EmberHeavyIndustries/AMI-RGB2VGAPLUS/Docs/RGB2VGA2_1s.JPG

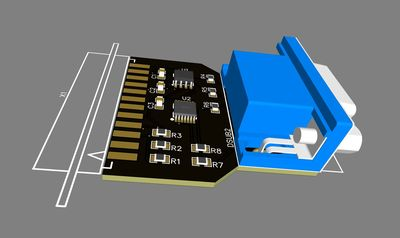
Docs/RGB2VGA2_1s.JPG
