EmberHeavyIndustries/AMI-RGB2VGAPLUS/Hardware/BOM_PCB_RGB2VGA_V2_2023-01-01.csv

ID | Name | Designator | Footprint | Quantity | Manufacturer Part | Manufacturer | Supplier | Supplier Part | Price
1 | 10uF | C2 | C0805 | 1 | CL21A106KPFNNNE | SAMSUNG(三星) | LCSC | C17024 | 0.002
2 | VGA-002 | DSUB2 | D-SUB-TH_VGA-002 | 1 | VGA-002 | BOOMELE(博穆精密) | LCSC | C138387 | 0.036
3 | THS7316D | U1 | SOIC-8_L5.0-W4.0-P1.27-LS6.1-BL | 1 | THS7316D | TI(德州仪器) | LCSC | C544874 | 0.075
4 | SN74HCT14PWR | U2 | TSSOP-14_L5.0-W4.4-P0.65-LS6.4-BL | 1 | SN74HCT14PWR | TI(德州仪器) | LCSC | C133639 | 0.039
5 | DB23_VTX | X1 | DB23_VTX | 1
6 | 100nF | C1,C3 | C0805 | 2 | CC0805KRX7R9BB104 | YAGEO(国巨) | LCSC | C49678 | 0.001
7 | - | R1,R2,R3,R4,R5,R6 | R0805 | 6 | 0805W8F750JT5E (SMT业务专用) | null | LCSC | C20638
8 | 100Ω | R7,R8 | R0805 | 2 | 0805W8F1000T5E | UNI-ROYAL(厚声) | LCSC | C17408
