EmberHeavyIndustries/AMI-RGB2VGAPLUS/Hardware/3D/C138387/VGA-002-solid.stl

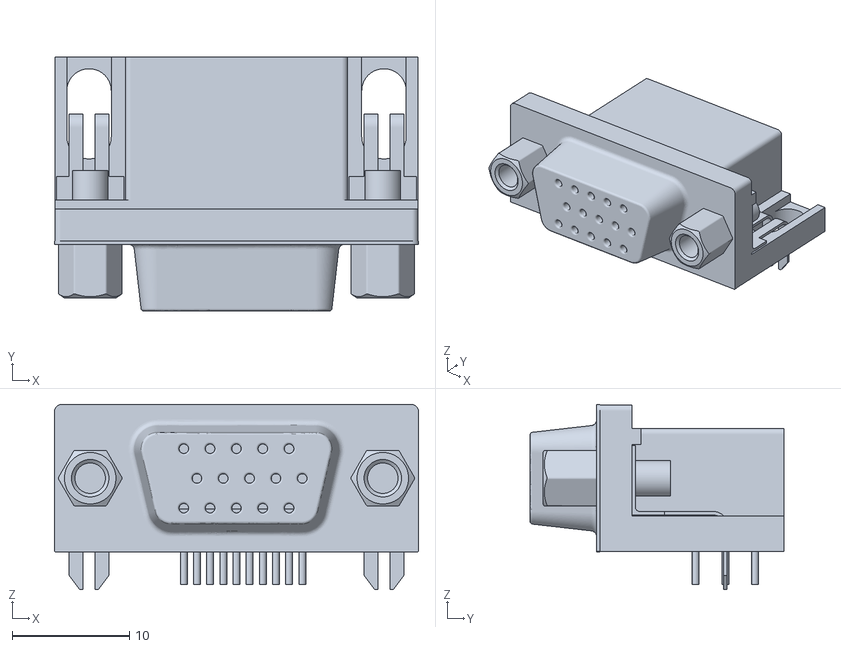
[picture p3: CAD file, 2026-11-02]
Hardware/3D/C138387/VGA-002-solid.stl
31.1 x 21.7 x 15.8
