EmberHeavyIndustries/AMI-RGB2VGAPLUS/Hardware/3D/DB23/DB23-female.step

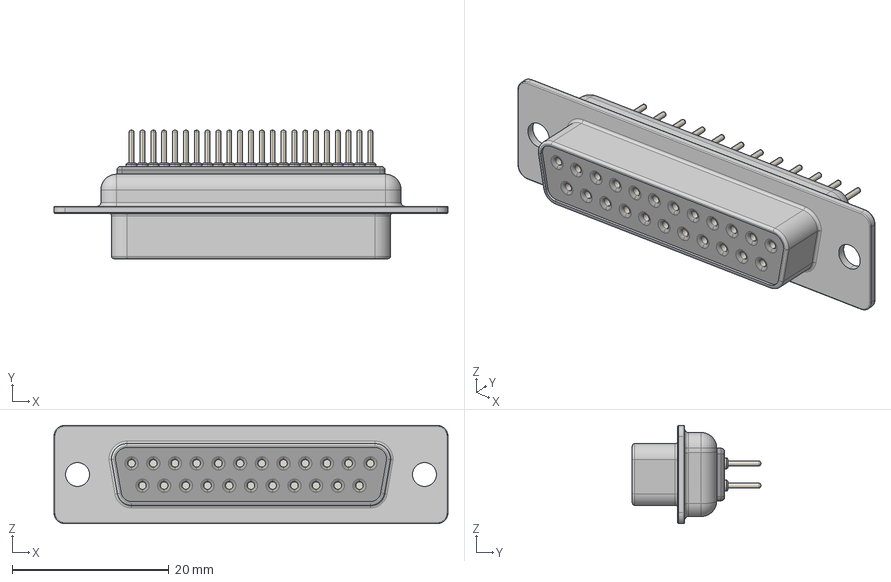
[picture p4: CAD file, 2026-11-02]
Hardware/3D/DB23/DB23-female.step
50.3 x 16.4 x 12.6 mm
