EmberHeavyIndustries/AMI-RGB2VGAPLUS/stl/lid.stl

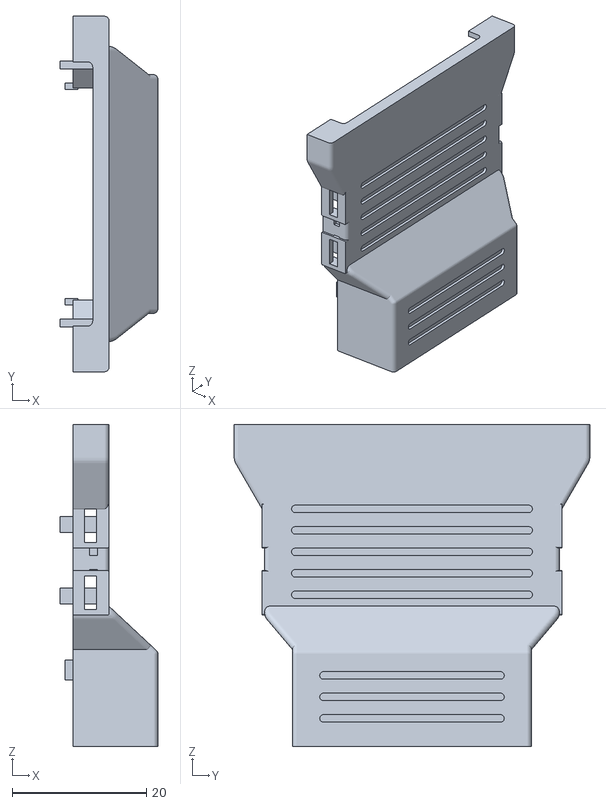
[picture p5: CAD file, 2026-11-02]
stl/lid.stl
14.6 x 53.0 x 48.0
