EmberHeavyIndustries/AMI-RGB2VGAPLUS/(list of files, cad)

Other CAD files:
Hardware/3D/C138387/VGA-002.obj
Hardware/3D/DB23/DB23-female.stl
