EmberHeavyIndustries/AMI-RGB2VGAPLUS/Hardware/Schematic_RGB2VGA_V2_2023-01-26.pdf

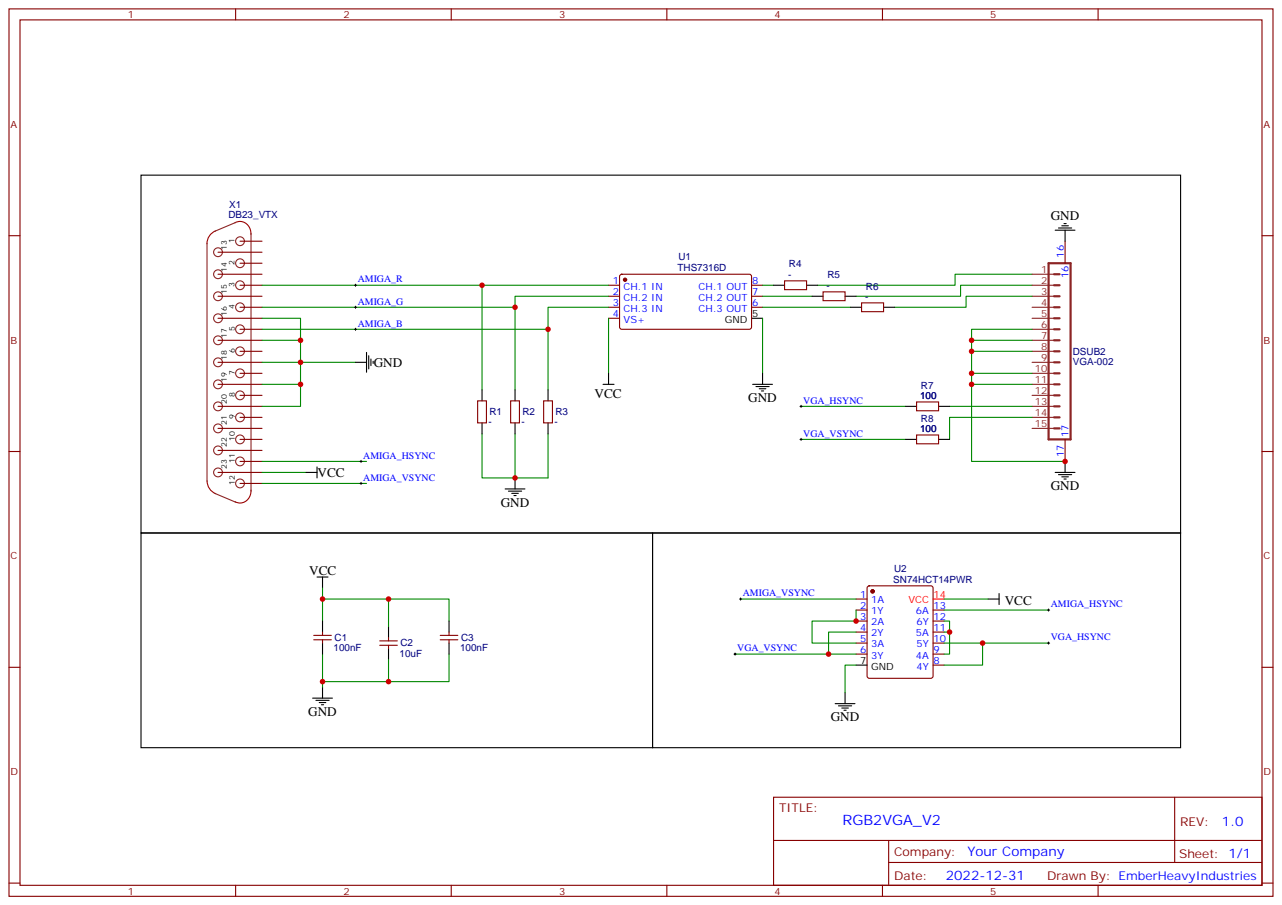
[picture p6: page 1]
